electricpocket/autopilot/(commit log)

2021-11-01 new layout and support for automate analogue voltages for light
2021-11-01 port and stud buttons
2021-11-04 AUTOHELM Arduino
